Mutilar/Marp/readme.md

# Marp

### High-Level Wiring Diagram

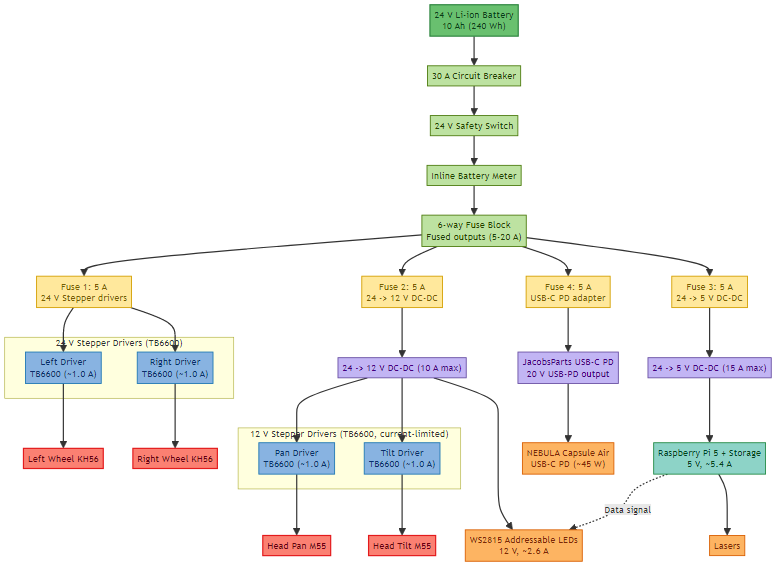
[picture p1: assets/diagrams/high-level-wiring.png]
High-Level Wiring Diagram


> Color key: power distribution (green hues), individual fuses (yellow), drivers (blue), converters (lavender), compute core (teal), peripherals (orange), and motors (red).

<details>
<summary>Mermaid source</summary>

<!-- mermaid-output: assets/diagrams/high-level-wiring.png -->
```mermaid
graph TD
    Battery["24 V Li-ion Battery\n10 Ah (240 Wh)"]
    Breaker["30 A Circuit Breaker"]
    Switch["24 V Safety Switch"]
    Meter["Inline Battery Meter"]
    FuseBlock["6-way Fuse Block\nFused outputs (5-20 A)"]
    FuseStepper24["Fuse 1: 5 A\n24 V Stepper drivers"]
    FuseBuck12["Fuse 2: 5 A\n24 -> 12 V DC-DC"]
    FuseBuck5["Fuse 3: 5 A\n24 -> 5 V DC-DC"]
    FusePD["Fuse 4: 5 A\nUSB-C PD adapter"]
    subgraph StepperDrivers24["24 V Stepper Drivers (TB6600)"]
        direction TB
        Stepper24Left["Left Driver\nTB6600 (~1.0 A)"]
        Stepper24Right["Right Driver\nTB6600 (~1.0 A)"]
    end
    Buck12["24 -> 12 V DC-DC (10 A max)"]
    Buck5["24 -> 5 V DC-DC (15 A max)"]
    subgraph StepperDrivers12["12 V Stepper Drivers (TB6600, current-limited)"]
        direction TB
        Stepper12Pan["Pan Driver\nTB6600 (~1.0 A)"]
        Stepper12Tilt["Tilt Driver\nTB6600 (~1.0 A)"]
    end
    PDAdapter["JacobsParts USB-C PD\n20 V USB-PD output"]
    Projector["NEBULA Capsule Air\nUSB-C PD (~45 W)"]
    Pi["Raspberry Pi 5 + Storage\n5 V, ~5.4 A"]
    LEDs["WS2815 Addressable LEDs\n12 V, ~2.6 A"]

    Battery --> Breaker --> Switch --> Meter --> FuseBlock
    FuseBlock --> FuseStepper24 --> Stepper24Left
    FuseStepper24 --> Stepper24Right
    FuseBlock --> FuseBuck12 --> Buck12
    Buck12 --> Stepper12Pan
    Buck12 --> Stepper12Tilt
    FuseBlock --> FusePD --> PDAdapter --> Projector
    FuseBlock --> FuseBuck5 --> Buck5 --> Pi
    Buck12 --> LEDs
    Pi -.->|Data signal| LEDs
    Pi --> Lasers
    Stepper24Left --> LeftWheel["Left Wheel KH56"]
    Stepper24Right --> RightWheel["Right Wheel KH56"]
    Stepper12Pan --> HeadPan["Head Pan M55"]
    Stepper12Tilt --> HeadTilt["Head Tilt M55"]

    class Battery battery
    class Breaker,Switch,Meter,FuseBlock distribution
    class FuseStepper24,FuseBuck12,FuseBuck5,FusePD fuse
    class Stepper24Left,Stepper24Right,Stepper12Pan,Stepper12Tilt driver
    class Buck12,Buck5,PDAdapter converter
    class Pi compute
    class Projector,Audio,LEDs,Lasers peripheral
    class LeftWheel,RightWheel,HeadPan,HeadTilt motor

    classDef battery fill:#69c06f,stroke:#2e8540,color:#0b3d17,stroke-width:2px
    classDef distribution fill:#bde2a1,stroke:#4d7c0f,color:#234300,stroke-width:1.5px
    classDef fuse fill:#ffe89c,stroke:#d49f00,color:#7a5d00,stroke-width:1.5px
    classDef driver fill:#88b3e1,stroke:#1f78b4,color:#08306b,stroke-width:1.5px
    classDef converter fill:#c2b5f4,stroke:#6a51a3,color:#3f007d,stroke-width:1.5px
    classDef compute fill:#8dd3c7,stroke:#238b45,color:#00441b,stroke-width:1.5px
    classDef peripheral fill:#fdb462,stroke:#d95f02,color:#7f2704,stroke-width:1.5px
    classDef motor fill:#fb8072,stroke:#e31a1c,color:#67000d,stroke-width:2px
```

> Rendered with `scripts/render-mermaid.ps1 -OutputPath assets/diagrams/high-level-wiring.png` (the default invoked by `npm run render:mermaid`). Run the script after editing the Mermaid source below to refresh the image.
</details>

### Data Flow Diagram

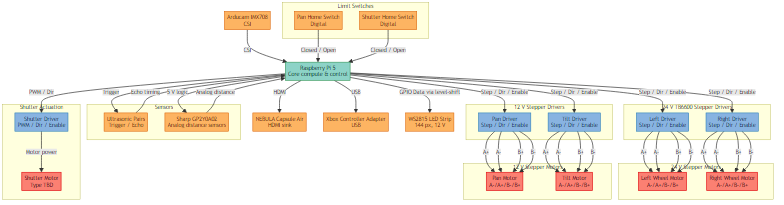
[picture p2: assets/diagrams/data-flow.png]
Data Flow Diagram


> Data flow color key: compute (teal), peripherals (orange), drivers (blue), motors (red).

<details>
<summary>Mermaid source</summary>

<!-- mermaid-output: assets/diagrams/data-flow.png -->
```mermaid
graph TB
    Pi["Raspberry Pi 5\nCore compute & control"]
    Projector["NEBULA Capsule Air\nHDMI sink"]
    Camera["Arducam IMX708\nCSI"]
    Controller["Xbox Controller Adapter\nUSB"]

    subgraph StepperDrivers24["24 V TB6600 Stepper Drivers"]
        StepperL["Left Driver\nStep / Dir / Enable"]
        StepperR["Right Driver\nStep / Dir / Enable"]
    end

    subgraph StepperDrivers12["12 V Stepper Drivers"]
        StepperPan["Pan Driver\nStep / Dir / Enable"]
        StepperTilt["Tilt Driver\nStep / Dir / Enable"]
    end

    subgraph StepperMotors24["24 V Stepper Motors"]
        MotorLeft["Left Wheel Motor\nA-/A+/B-/B+"]
        MotorRight["Right Wheel Motor\nA-/A+/B-/B+"]
    end

    subgraph StepperMotors12["12 V Stepper Motors"]
        MotorPan["Pan Motor\nA-/A+/B-/B+"]
        MotorTilt["Tilt Motor\nA-/A+/B-/B+"]
    end

    subgraph SensorCluster["Sensors"]
        UltrasonicArray["Ultrasonic Pairs\nTrigger / Echo"]
        IRArray["Sharp GP2Y0A02\nAnalog distance sensors"]
    end

    subgraph LimitSwitches["Limit Switches"]
        PanLimit["Pan Home Switch\nDigital"]
        ShutterLimit["Shutter Home Switch\nDigital"]
    end

    subgraph ShutterActuation["Shutter Actuation"]
        ShutterDriver["Shutter Driver\nPWM / Dir / Enable"]
        ShutterMotor["Shutter Motor\nType TBD"]
    end

    Pi -->|HDMI| Projector
    Camera -->|CSI| Pi
    Pi -->|USB| Controller
    Pi -->|Step / Dir / Enable| StepperL
    Pi -->|Step / Dir / Enable| StepperR
    Pi -->|Step / Dir / Enable| StepperPan
    Pi -->|Step / Dir / Enable| StepperTilt
    Pi -->|PWM / Dir| ShutterDriver
    Pi -->|GPIO Data via level-shift| LEDs["WS2815 LED Strip\n144 px, 12 V"]
    Pi -->|Trigger| UltrasonicArray
    UltrasonicArray -->|Echo timing| Pi
    IRArray -->|Analog distance| Pi
    Pi -->|5 V logic| IRArray
    PanLimit -->|Closed / Open| Pi
    ShutterLimit -->|Closed / Open| Pi

    StepperL -->|A+| MotorLeft
    StepperL -->|A-| MotorLeft
    StepperL -->|B+| MotorLeft
    StepperL -->|B-| MotorLeft
    StepperR -->|A+| MotorRight
    StepperR -->|A-| MotorRight
    StepperR -->|B+| MotorRight
    StepperR -->|B-| MotorRight
    StepperPan -->|A+| MotorPan
    StepperPan -->|A-| MotorPan
    StepperPan -->|B+| MotorPan
    StepperPan -->|B-| MotorPan
    StepperTilt -->|A+| MotorTilt
    StepperTilt -->|A-| MotorTilt
    StepperTilt -->|B+| MotorTilt
    StepperTilt -->|B-| MotorTilt
    ShutterDriver -->|Motor power| ShutterMotor

    class Pi compute
    class Projector,Camera,Controller,UltrasonicArray,IRArray,PanLimit,ShutterLimit,LEDs peripheral
    class StepperL,StepperR,StepperPan,StepperTilt,ShutterDriver driver
    class MotorLeft,MotorRight,MotorPan,MotorTilt,ShutterMotor motor

    classDef compute fill:#8dd3c7,stroke:#238b45,color:#00441b,stroke-width:1.5px
    classDef peripheral fill:#fdb462,stroke:#d95f02,color:#7f2704,stroke-width:1.5px
    classDef driver fill:#88b3e1,stroke:#1f78b4,color:#08306b,stroke-width:1.5px
    classDef motor fill:#fb8072,stroke:#e31a1c,color:#67000d,stroke-width:2px
```

> Rendered with `scripts/render-mermaid.ps1 -OutputPath assets/diagrams/data-flow.png -DiagramIndex 1` (also covered by `npm run render:mermaid`). Run the script after editing the Mermaid source below to refresh the image.
</details>

### User Story Diagram

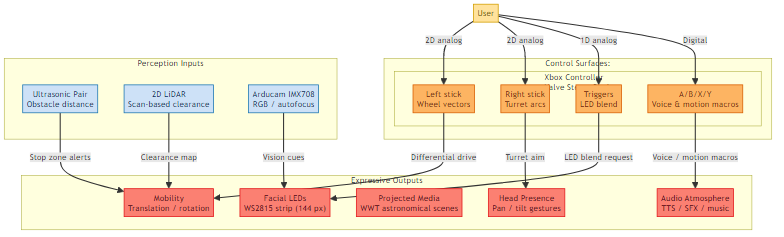
[picture p3: assets/diagrams/user-story.png]
User Story Diagram


> Shows how the User's control surfaces and onboard sensing map directly to the robot's expressive outputs.

<details>
<summary>Mermaid source</summary>

<!-- mermaid-output: assets/diagrams/user-story.png -->
```mermaid
graph TB
    User["User"]

    subgraph ControlSurfaces["Control Surfaces:"]
        subgraph XboxPad["Xbox Controller\nValve Steam Deck\n"]
            XLeft["Left stick\nWheel vectors"]
            XRight["Right stick\nTurret arcs"]
            XTrig["Triggers\nLED blend"]
            XFace["A/B/X/Y\nVoice & motion macros"]
        end
    end

    subgraph Perception["Perception Inputs"]
        Ultrasonic["Ultrasonic Pair\nObstacle distance"]
        Lidar["2D LiDAR\nScan-based clearance"]
        Arducam["Arducam IMX708\nRGB / autofocus"]
    end

    subgraph Expression["Expressive Outputs"]
        Mobility["Mobility\nTranslation / rotation"]
        Head["Head Presence\nPan / tilt gestures"]
        Projection["Projected Media\nWWT astronomical scenes"]
        Audio["Audio Atmosphere\nTTS / SFX / music"]
        LEDs["Facial LEDs\nWS2815 strip (144 px)"]
    end

    User -->|2D analog| XLeft
    User -->|2D analog| XRight
    User -->|1D analog| XTrig
    User -->|Digital| XFace

    XLeft -->|Differential drive| Mobility
    XRight -->|Turret aim| Head
    XTrig -->|LED blend request| LEDs
    XFace -->|Voice / motion macros| Audio

    Ultrasonic -->|Stop zone alerts| Mobility
    Lidar -->|Clearance map| Mobility
    Arducam -->|Vision cues| LEDs

    class User actor
    class XLeft,XRight,XTrig,XFace,DLeft,DRight,DTrig,DMacro input
    class Ultrasonic,Lidar,Arducam sensor
    class Mobility,Head,Projection,Audio,LEDs output

    classDef actor fill:#ffe29c,stroke:#d49f00,color:#7a5d00,stroke-width:1.5px
    classDef input fill:#fdb462,stroke:#d95f02,color:#7f2704,stroke-width:1.5px
    classDef sensor fill:#cde1f7,stroke:#1f78b4,color:#08306b,stroke-width:1.5px
    classDef output fill:#fb8072,stroke:#e31a1c,color:#67000d,stroke-width:1.5px
```

> Rendered with `scripts/render-mermaid.ps1 -OutputPath assets/diagrams/user-story.png -DiagramIndex 2` (also covered by `npm run render:mermaid`). Run the script after editing the Mermaid source above to refresh the image.
</details>

# Raspberry Pi Robot Controller

This project runs on a Raspberry Pi 5 to control a 4-axis robot (2 Drive Steppers + 2 Turret Steppers). It supports control via a local USB Joystick (Xbox controller) or via UDP network packets (e.g., from a Steam Deck over Wi-Fi Direct). It also streams low-latency H.264 video to the connected client.

## Features
*   **Motor Control**: Drives 4 stepper motors using `lgpio` for precise timing.
*   **Dual Input**: Seamlessly switches between local USB Joystick and Network UDP commands.
*   **Safety**: Auto-stops motors if network connection is lost for >1 second.
*   **Wi-Fi Direct**: Acts as a Group Owner (Hotspot) for easy field connection without a router.
*   **Video Streaming**: Low-latency hardware-accelerated streaming via `rpicam-vid`.
*   **Systemd Integration**: Auto-starts all services on boot.

## System Architecture

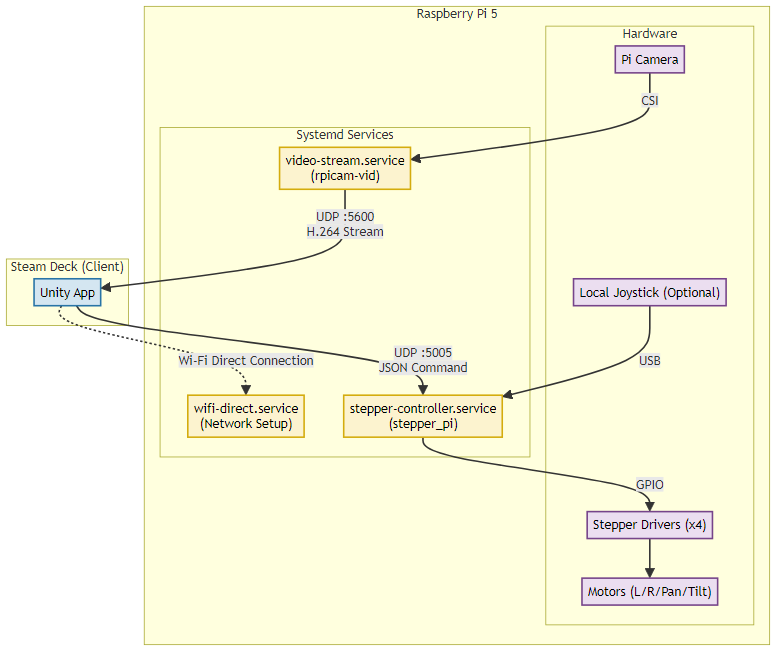
[picture p4: assets/diagrams/architecture.png]
Architecture


> Color key: **Blue**=Client, **Yellow**=Services, **Purple**=Hardware

<details>
<summary>Mermaid source</summary>
<!-- mermaid-output: assets/diagrams/architecture.png -->
```
graph TD
    %% Nodes
    subgraph Client["Steam Deck (Client)"]
        Unity["Unity App"]
    end

    subgraph Robot["Raspberry Pi 5"]
        subgraph Services["Systemd Services"]
            WifiService["wifi-direct.service<br/>(Network Setup)"]
            StepService["stepper-controller.service<br/>(stepper_pi)"]
            VidService["video-stream.service<br/>(rpicam-vid)"]
        end
        
        subgraph Hardware
            Camera["Pi Camera"]
            Drivers["Stepper Drivers (x4)"]
            Motors["Motors (L/R/Pan/Tilt)"]
            LocalJoy["Local Joystick (Optional)"]
        end
    end

    %% Network Interactions
    Unity -.->|Wi-Fi Direct Connection| WifiService
    Unity -->|UDP :5005<br/>JSON Command| StepService
    VidService -->|UDP :5600<br/>H.264 Stream| Unity

    %% Internal Interactions
    StepService -->|GPIO| Drivers
    Drivers --> Motors
    LocalJoy -->|USB| StepService
    Camera -->|CSI| VidService

    %% Styling
    classDef client fill:#d4e6f1,stroke:#2874a6,stroke-width:2px,color:black;
    classDef service fill:#fcf3cf,stroke:#d4ac0d,stroke-width:2px,color:black;
    classDef hardware fill:#ebdef0,stroke:#76448a,stroke-width:2px,color:black;
    
    class Unity client;
    class WifiService,StepService,VidService service;
    class Camera,Drivers,Motors,LocalJoy hardware;
</details>

# Bill of Materials (BOM)

## Control & Compute
| Component | Role | Voltage (V) | Amperage (A) | Wattage (W) | Physical Dimensions (") | Link | Notes |
| --- | --- | --- | --- | --- | --- | --- | --- |
| Controller | Operator input | 5 | ≤1.5 | ≤7.5 | Gamepad form factor | [Xbox Elite Controller](https://www.xbox.com/en-US/accessories/controllers/elite-wireless-controller-series-2) | Wired or wireless dual joysticks, triggers, and action buttons. |
| Handheld Console | Operator input/output | 5–20 (USB-C PD) | ≤3.0 | ≤45 | 11.7" × 4.6" × 1.9" | [Valve Steam Deck](https://store.steampowered.com/steamdeck) | Wireless dual joysticks, triggers, and action buttons with real-time video stream and diagonistics. |
| Robot Computer | Onboard coordination & processing | 5 | ≤5.4 | ≤27 | 3.35" × 2.20" × 0.71" | [Raspberry Pi 5](https://www.raspberrypi.com/products/raspberry-pi-5/) | Wi-Fi / Bluetooth / USB; CSI/DSI; 16 GB RAM, 64 GB SD. |

## Locomotion
| Component | Voltage (V) | Amperage (A) | Wattage (W) | Physical Dimensions (") | Link | Notes |
| --- | --- | --- | --- | --- | --- | --- |
| Left wheel | 24 | 2.5 | 60 | 2.20" | [Nidec](https://www.nidec-advancedmotor.com/en/digital/pdf/KH56Q.pdf) | KH56 Stepper Motor |
| Right wheel | 24 | 2.5 | 60 | 2.20" | [Nidec](https://www.nidec-advancedmotor.com/en/digital/pdf/KH56Q.pdf) | KH56 Stepper Motor |
| Drivers | 24 | ≤2.5 | ≤120 | 3.4" × 1.8" × 1.3" | [Makerguides](https://www.makerguides.com/tb6600-stepper-motor-driver-arduino-tutorial/) | TB6600 × 4 (two on wheels, two reserved for turret axes). |

## Actuation

| Component | Voltage (V) | Amperage (A) | Wattage (W) | Physical Dimensions (") | Link | Notes |
| --- | --- | --- | --- | --- | --- | --- |
| Head pan | 12 | 1.0 | 12 | Ø2.17" × 0.98" | [Mitsumi](https://product.minebeamitsumi.com/en/product/category/rotary/steppingmotor/pm/PMStandardtype.html) | M55SP-3NK Stepper Motor (stocked on [Radwell](https://www.radwell.com/Buy/MITSUMI/MITSUMI/M55SP-2NK)) |
| Head tilt | 12 | 1.0 | 12 | Ø2.17" × 0.98" | [Mitsumi](https://product.minebeamitsumi.com/en/product/category/rotary/steppingmotor/pm/PMStandardtype.html) | M55SP-3NK Stepper Motor (stocked on [Radwell](https://www.radwell.com/Buy/MITSUMI/MITSUMI/M55SP-2NK)) |
| Drivers (shared TB6600 bank) | 24 | ≤2.5 | ≤120 | 3.4" × 1.8" × 1.3" | [Makerguides](https://www.makerguides.com/tb6600-stepper-motor-driver-arduino-tutorial/) | Same TB6600 stack as wheels; pan/tilt channels limit current for 12 V coils. |
| Shutter motor driver | TBD | TBD | TBD | TBD | — | H-bridge driver; 5 V logic with 12 V motor rail; commanded directly by the Pi. |
| Shutter motor | TBD | TBD | TBD | TBD | — | Motorized projector shutter (non-stepper); homed via limit switch. |

## Power & Electronics
| Component | Voltage (V) | Amperage (A) | Wattage (W) | Physical Dimensions (") | Link | Notes |
| --- | --- | --- | --- | --- | --- | --- |
| Lithium Battery | 24 | 5 (Continuous), 10 (Peak) | 240 Wh | 5.8" × 3.2" × 2.8" | [Aegis](https://www.aegisbattery.com/collections/24v-lithium-batteries/products/aegis-24v-10ah-lithium-ion-battery-pack-nmc-24v-lithium-battery) | 10 Ah NMC pack (≈240 Wh capacity). |
| Battery Meter | 24 | ≤0.5 | ≤1.2 | 85mm x W: 42mm x H: 25mm | [Aegis](https://www.aegisbattery.com/collections/lithium-battery-meters-instruments/products/high-precision-battery-200a-watt-meter-and-power-analyzer) | Inline 200 A analyzer (voltage, amps, watts). |
| USB-C Meter (x2) | 5 | ≤0.1 | ≤0.25 | 36.7mm x W: 23.7mm x H: 7.8mm | [POWER-Z](https://www.amazon.com/dp/B0C9Q3RT7Z) | Inline USB-C analyzer (voltage, amps, watts). |
| Anderson PP45 → ring adapter | 24 | 20 | 480 | M10 ring | [Aegis](https://www.aegisbattery.com/collections/adapters/products/anderson-to-ring-terminal-adapter) | Quick battery-to-system interface. |
| Circuit Breaker | 24 | 30 | 720 | 1.73"D x 1.93"W x 2.91"H | [Hamolar](https://www.amazon.com/gp/product/B095Z2F5F7/ref=ewc_pr_img_2?smid=A2TJVE0ZQTOQDP&th=1) | Main battery protection. |
| Safety Switch | 24 | 16 | 384 | 4.88 x 2.24 x 2.09 | [Vonvoff](https://www.amazon.com/dp/B0CKXPNBB2?ref=ppx_yo2ov_dt_b_fed_asin_title&th=1) | Manual 24 V disconnect. |
| Fuse Block | 24 | 5–20 (per branch) | ≤640 (aggregate) | 3.66" × 1.77" × 4.88" | [Tutooper](https://www.amazon.com/gp/product/B0F4NJK6MZ/ref=ewc_pr_img_1?smid=AAWQNNL1TJNS4&th=1) | Six-position low-voltage distribution. |
| 12 V Converter | 24→12 | 10 | 120 | 2.04"D x 1.88"W x 0.74"H | [Tobsun](https://www.amazon.com/gp/product/B07V6X6L89/ref=ewc_pr_img_1?smid=A3GYM455B71YGR&th=1) | DC-DC buck for 12 V peripherals. |
| 5 V Converter | 24→5 | 15 | 75 | 0.71"D x 1.26"W x 0.71"H | [Tobsun](https://www.amazon.com/dp/B0BLSGDVHF?ref=ppx_yo2ov_dt_b_fed_asin_title) | DC-DC buck for logic and compute loads. |
| JacobsParts USB-C PD adapter | 12/24→5–20 | ≤3 (PD) | 45 | TBD | [Amazon](https://www.amazon.com/dp/B08P3YXXPG) | USB-C PD plus USB-A QC3.0 module (5.5×2.1 mm input) for projector/compute power. |
| Waterproof USB-C buck (2-pack) | 12/24→5 | 5 | 25 | TBD (potted) | [Amazon](https://www.amazon.com/dp/B0CRVVWL4Y) | Epoxy-potted USB-C step-down pair for Pi 5 or peripheral loads. |

## Cabling & Interconnects
| Item | Purpose | Length | Rating | Link | Notes |
| --- | --- | --- | --- | --- | --- |
| USB-C short cables (2-pack) | Power jumpers between DC buck outputs and Pi/projector | 6" | USB-C PD / 60 W | [Amazon](https://www.amazon.com/dp/B0CL4HS7W7) | Braided C-to-C leads sized for tight enclosures; keeps USB-C PD adapters tidy. |
| PowerBear HDMI cable | Pi-to-projector video link | 0.5 ft | 4K @ 60 Hz | [Amazon](https://www.amazon.com/dp/B08J8BJQLB) | Short, braided HDMI interconnect to limit slack near the projector mount. |

## Sensors & Outputs

### Distance & Environment
| Sensor | Range / Resolution | Coverage | Voltage (V) | Amperage (A) | Wattage (W) | Physical Dimensions (") | Link | Notes |
| --- | --- | --- | --- | --- | --- | --- | --- | --- |
| Ultrasonic pair (x2 sets) | Short-range (TBD) | Front/Rear or side placements TBD | 5 | ≤0.015 | ≤0.075 | ~1.77" × 0.79" modules | — | Use overlapping fields to reduce blind spots; polled directly from the Pi over GPIO/I²C. |
| Sharp GP2Y0A02 (~10) | 20–150 cm / analog voltage | Perimeter coverage via multi-sensor ring | 4.5–5.5 | ≤0.033 | ≤0.17 | 1.57" × 0.63" × 0.85" | [Sharp GP2Y0A02YK0F](https://global.sharp/products/device/lineup/data/pdf/datasheet/gp2y0a02yk_e.pdf) | Analog 0.4–2.8 V output into a Pi ADC front-end; add filtering and shielding for stable readings. |

### Contact & Limit Sensing

| Component | Role | Voltage (V) | Amperage (A) | Wattage (W) | Physical Dimensions (") | Link | Notes |
| --- | --- | --- | --- | --- | --- | --- | --- |
| Pan home limit switch | Homing reference for head pan axis | 5 | ≤0.02 | ≤0.1 | TBD | — | Lands on a Pi GPIO with pull-up to define the zero position. |
| Shutter home limit switch | Homing reference for projector shutter | 5 | ≤0.02 | ≤0.1 | TBD | — | Confirms shutter closed position; debounced in Pi software. |

### Vision & Interaction
| Component | Function | Coverage / Resolution | Voltage (V) | Amperage (A) | Wattage (W) | Physical Dimensions (") | Link | Notes |
| --- | --- | --- | --- | --- | --- | --- | --- | --- |
| Mini Projector | Visual output | 720p (150 ANSI) | 5–20 (USB-C PD) | ≤2.25 | ≤45 | Ø2.7" × 5.5" | [NEBULA Capsule Air](https://www.amazon.com/dp/B0CWV1S7B4?ref=ppx_yo2ov_dt_b_fed_asin_title&th=1) | Built-in 34 Wh battery; integrate 45 W USB-C PD or leverage internal pack. |
| Camera | Vision input | 12 MP, 75° FoV; autofocus | 5 | ≤0.5 | ≤2.5 | 1.50" × 1.50" × 0.71" (w/ adapter) | [Arducam](https://www.amazon.com/dp/B0C9PYCV9S?ref=ppx_yo2ov_dt_b_fed_asin_title) | IMX708 |
| BTF-LIGHTING WS2815 LED strip | Face ring (eyes, mouth) | 144 LEDs, individually addressable RGB | 12 | ≤2.6 (full white) | ≤31.7 | 3.2 ft × 0.47" (1 m × 12 mm), IP65 | [Amazon](https://www.amazon.com/dp/B07LG5VF73) | Upgraded WS2812B; dual-signal line; 5050 SMD; 12 V from Buck12 rail; data pin needs 3.3→5 V level-shift. |
